Am0k-GIT/STM32F401CCU6_board/Photo/1664820074301.jpg

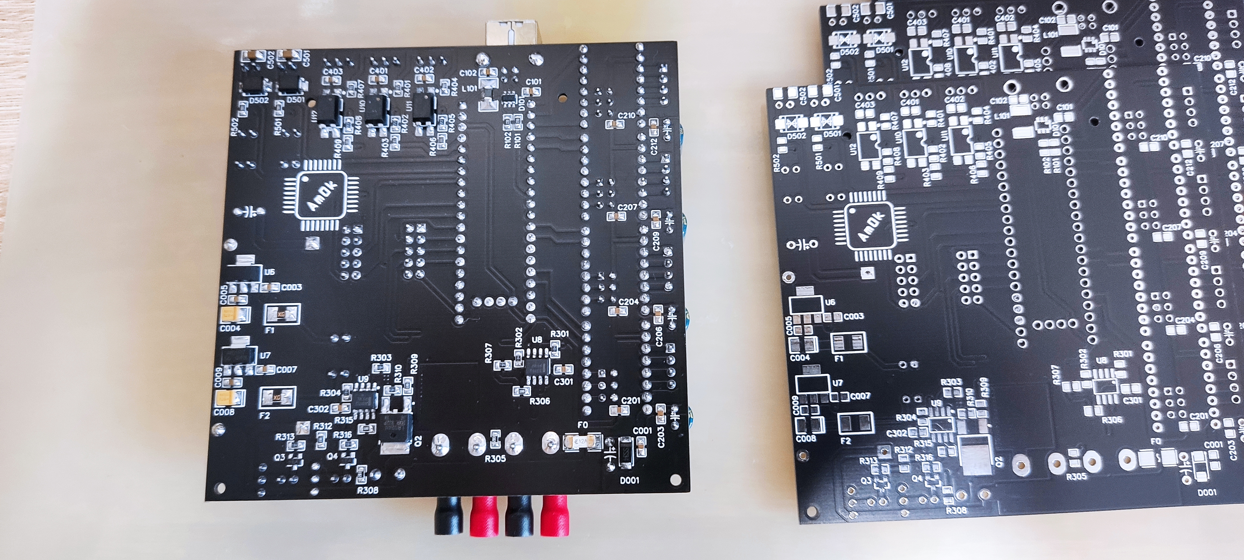
Photo/1664820074301.jpg
