Am0k-GIT/STM32F401CCU6_board/Photo/1664820074309.jpg

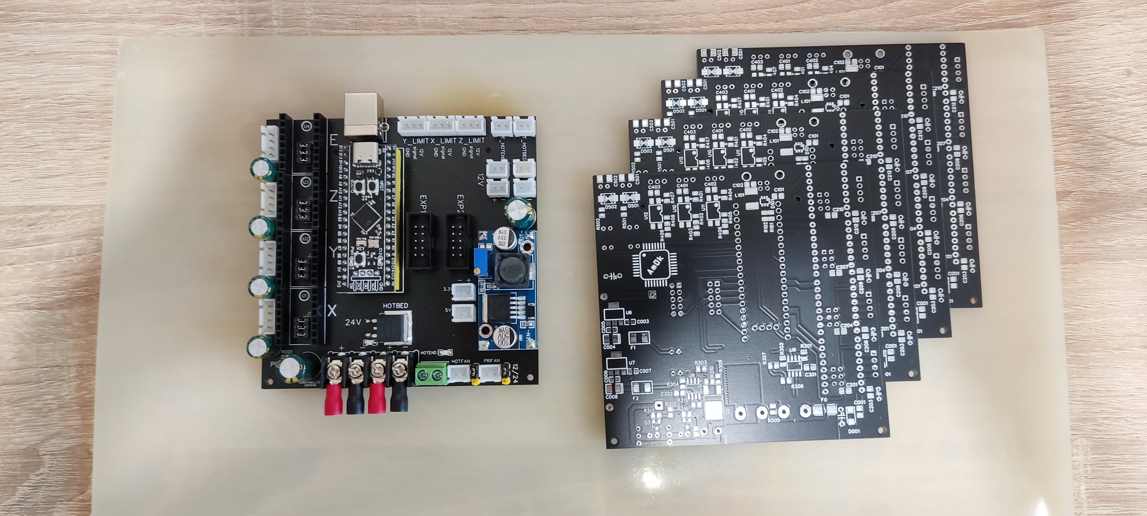
Photo/1664820074309.jpg
