Am0k-GIT/STM32F401CCU6_board/files/BOM.xlsx

Name | Designator | Quantity | Price | Total price | Link
 | Resistors
0805 SMD Resistor 10Ω | R306, R309, R312, R315 | 4 | $0.005 | $0.020 | https://aliexpress.ru/item/32858225842.html?sku_id=65342762295
0805 SMD Resistor 20Ω | R101, R102 | 2 | $0.005 | $0.010 | https://aliexpress.ru/item/32858225842.html?sku_id=65342762295
0805 SMD Resistor 100Ω | R403, R406, R409 | 3 | $0.005 | $0.015 | https://aliexpress.ru/item/32858225842.html?sku_id=65342762295
0805 SMD Resistor 1kΩ | R401, R404, R407, R501, R502 | 3 | $0.005 | $0.015 | https://aliexpress.ru/item/32858225842.html?sku_id=65342762295
0805 SMD Resistor 5.1kΩ | R001, R305, R308, R402, R405, R408 | 8 | $0.005 | $0.040 | https://aliexpress.ru/item/32858225842.html?sku_id=65342762295
0805 SMD Resistor 100kΩ | R301, R302, R303, R304, R307, R310, R313, R316 | 8 | $0.005 | $0.040 | https://aliexpress.ru/item/32858225842.html?sku_id=65342762295
 |  |  |  | $0.000
 |  |  |  | $0.000
 |  |  |  | $0.000
 | Capacitors |  |  | $0.000
0805 SMD Capacitor 0.1uF | C001, C003, C005, C007, C009, C101, C102, C201, C203, C204, C206, C207, C209, C210, C212, C301, C302, C401, C402, C403 | 20 | $0.009 | $0.180 | https://aliexpress.ru/item/32964553793.html?sku_id=66561886412
1206 SMD Capacitor 0.47uF | C501, C502 | 2 | $0.009 | $0.018 | https://aliexpress.ru/item/32966490820.html?sku_id=66631208523
Tantalum B case 68uF/10V | C004, C008 | 2 | $0.108 | $0.216 | https://aliexpress.ru/item/1005003568822210.html?sku_id=12000026320432579
Electrolytic capacitor 220uF/35V | C202, C205 ,C208, C211 | 4 | $0.049 | $0.196 | https://aliexpress.ru/item/32812576995.html?sku_id=12000021924638874
Electrolytic capacitor 470uF/25V | C002 | 1 | $0.055 | $0.055 | https://aliexpress.ru/item/32812576995.html?sku_id=12000021924638874
Electrolytic capacitor 330uF/35V | C010 | 1 | $0.094 | $0.094 | https://aliexpress.ru/item/32812576995.html?sku_id=12000021924638874
 |  |  |  | $0.000
 |  |  |  | $0.000
 |  |  |  | $0.000
 | Inductors |  |  | $0.000
1206 SMD Inductor 1uH | L101 | 1 | $0.027 | $0.027 | https://aliexpress.ru/item/32859730985.html?sku_id=65346066542
 |  |  |  | $0.000
 |  |  |  | $0.000
 |  |  |  | $0.000
 | Diodes |  |  | $0.000
SS56 | D001 | 1 | $0.029 | $0.029 | https://aliexpress.ru/item/32731083055.html?sku_id=12000025003881448
SMBJ3.3CA | D501, D502 | 2 | $0.099 | $0.198 | https://aliexpress.ru/item/1005002935595198.html?sku_id=12000022869824508
1206 LED Red | LED1, LED2, LED0 | 3 | $0.007 | $0.021 | https://aliexpress.ru/item/1206456185.html?sku_id=12000020819360623
 |  |  |  | $0.000
 |  |  |  | $0.000
 |  |  |  | $0.000
 | Mosfets |  |  | $0.000
IRLML0040TRPbF | Q3, Q4 | 2 | $0.130 | $0.260 | https://aliexpress.ru/item/33020199427.html?sku_id=67238732388
IRLR024NTRLPBF | Q2 | 1 | $0.138 | $0.138 | https://aliexpress.ru/item/32495256002.html?sku_id=56920336665
IRLS3034PBF | Q1 | 1 | $0.796 | $0.796 | https://aliexpress.ru/item/1005002717718800.html?sku_id=12000021839519371
 |  |  |  | $0.000
 |  |  |  | $0.000
 |  |  |  | $0.000
 | MC |  |  | $0.000
USBLC6-2SC6 | D101 | 1 | $0.108 | $0.108 | https://aliexpress.ru/item/32523780535.html?sku_id=12000027513378590
MC33152DR2G | U8, U9 | 2 | $0.433 | $0.866 | https://aliexpress.ru/item/32881664488.html?sku_id=12000025561707873
LM1117-3.3 | U6 | 1 | $0.368 | $0.368 | https://aliexpress.ru/item/1005003525206401.html?sku_id=12000026170984807
LM1117-5 | U7 | 1 | $0.368 | $0.368 | https://aliexpress.ru/item/1005003525206401.html?sku_id=12000026170984807
PC817S | U10, U11, U12 | 3 | $0.044 | $0.132 | https://aliexpress.ru/item/4000330808302.html?sku_id=12000015953253591
 |  |  |  | $0.000
 |  |  |  | $0.000
 |  |  |  | $0.000
 | Fuses |  |  | $0.000
1808 fuse 12A | F0 | 1 | $0.196 | $0.196 | https://aliexpress.ru/item/1005003300435636.html?sku_id=12000025095022989
1808 fuse 2A | F1 | 1 | $0.196 | $0.196 | https://aliexpress.ru/item/1005003300435636.html?sku_id=12000025095022989
3216 resetable fuse 0.5A | F2, F3 | 2 | $0.063 | $0.126 | https://aliexpress.ru/item/32876140005.html?sku_id=12000015531208019
 |  |  |  | $0.000
 |  |  |  | $0.000
 | Connectors |  |  | $0.000
XH-2.54 2pin | 3.3V, 5V, 12V_2, 12V_3, 12V_3,12V_4, HOTFAN, PRIFAN, T_HOTBED, T_HOTEND | 10 | $0.029 | $0.290 | https://aliexpress.ru/item/1005003422202370.html?sku_id=12000025716082486
XH-2.54 3pin | X_LIMIT, Y_LIMIT, Z_LIMIT | 3 | $0.031 | $0.093 | https://aliexpress.ru/item/1005003422202370.html?sku_id=12000025716082486
XH-2.54 4pin | E, X, Y, Z | 4 | $0.033 | $0.132 | https://aliexpress.ru/item/1005003422202370.html?sku_id=12000025716082486
HRD-2x3-2.54-MALE | J1, J2 ,J3, J4 | 4 | $0.058 | $0.232 | https://aliexpress.ru/item/1005004560139168.html?sku_id=12000029617433770
HRD-1x3-2.54-MALE | POWERSWITCH1, POWERSWITCH2 | 2 | $0.007 | $0.014 | https://aliexpress.ru/item/32329810741.html?sku_id=10000001992581053
KF301-5.0-2P | HOTEND | 1 | $0.034 | $0.034 | https://aliexpress.ru/item/4000290521933.html?sku_id=10000001206687839
KF7.62 4-PIN | POWER | 1 | $0.192 | $0.192 | https://aliexpress.ru/item/32924525467.html?sku_id=10000002275293516
BH-10 | EXP1, EXP2 | 2 | $0.150 | $0.300 | https://aliexpress.ru/item/1005001400147026.html?sku_id=12000015951389182
USB-B | USB1 | 1 | $0.122 | $0.122 | https://aliexpress.ru/item/32834923469.html?sku_id=64995523925
HRD-1x8-2.54-FEMALE | U1, U2, U3, U4 connectors | 8 | $0.044 | $0.352 | https://aliexpress.ru/item/32970948352.html?sku_id=66663329845
 |  |  |  | $0.000
 |  |  |  | $0.000
 |  |  |  | $0.000
 | Modules |  |  | $0.000
STM32F401CC | U0 | 1 | $2.867 | $2.867 | https://aliexpress.ru/item/32792513237.html?sku_id=10000015042616725
LM2596-Module-Schematic | U5 | 1 | $1.145 | $1.145 | https://aliexpress.ru/item/33004374185.html?sku_id=67088944738
A4988 | U1, U2, U3, U4 | 4 | $0.867 | $3.468 | https://aliexpress.ru/item/1005001621706694.html?sku_id=12000016846281613
 |  |  |  | $0.000
 |  |  |  | $0.000
 |  |  |  | $0.000
 | Manufacturing |  |  | $0.000
 | PCB build | 1 | $1.514 | $1.514 | https://jlcpcb.com/
 |  |  |  | $0.000
 |  |  |  | $0.000
 | Total: |  |  | $15.48
 | Цены приведены из учета первого попавшегося лота с заказами, включая стоимость доставки, при минимальном размере заказа, на 04.10.22
