Am0k-GIT/STM32F401CCU6_board/Schematic_Marlin_STM30F401CCU6.pdf

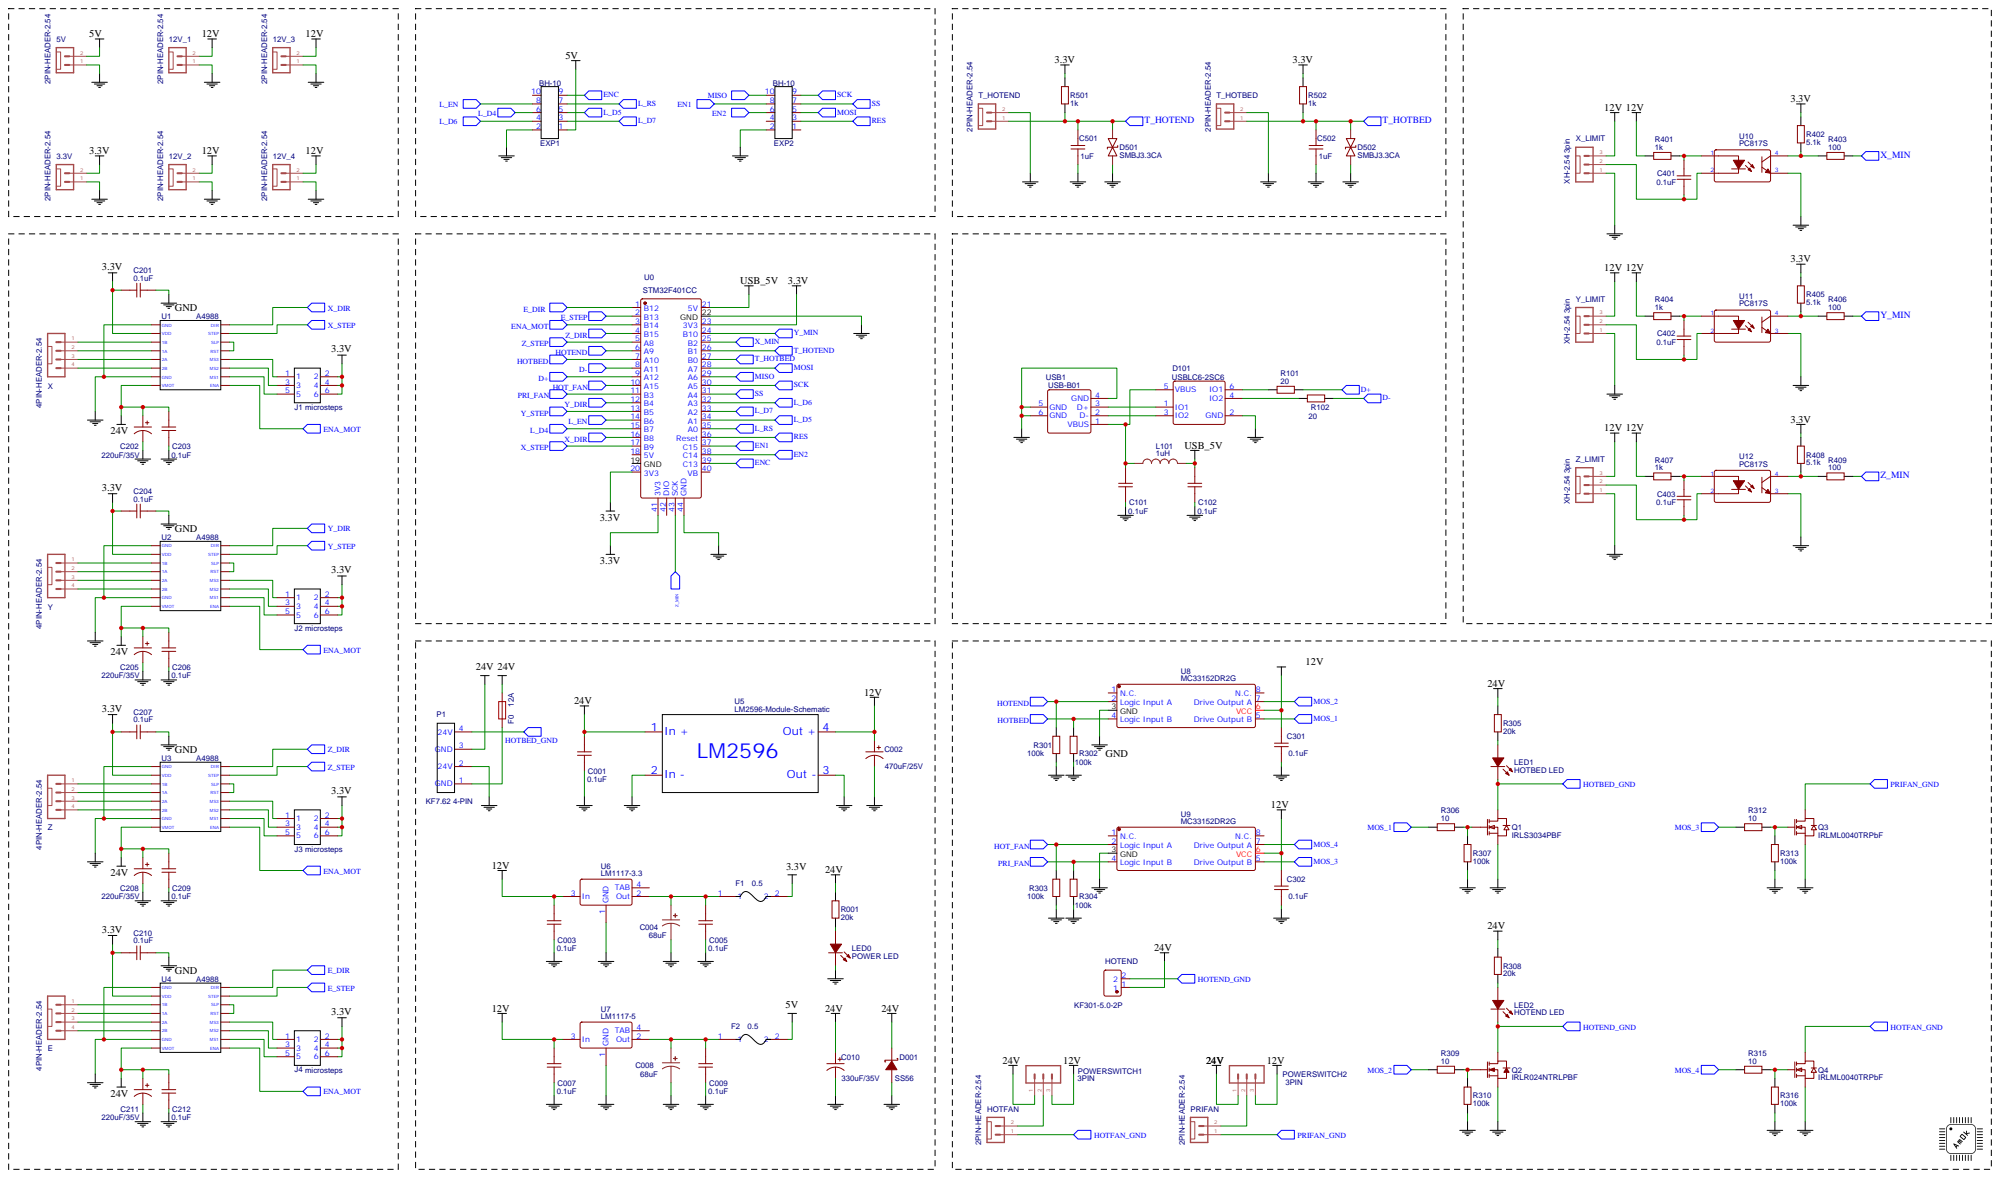
[picture p10: page 1]

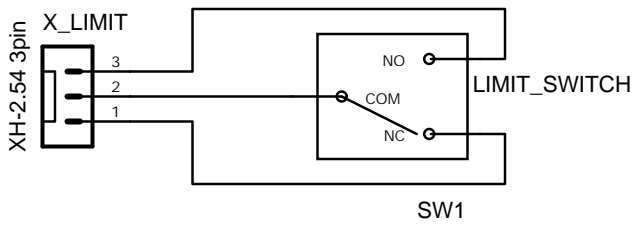
[picture p11: figure]
LIMIT_SWITCH; COM; XH-2.54 3pin; X_LIMIT
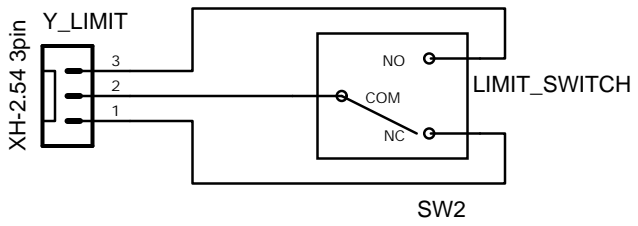
[picture p12: figure]
XH-2.54 3pin; Y_LIMIT; LIMIT_SWITCH; COM

LJ12A3-4-ZAX

SW3

Brown/VCC 1
Black/OUT 2
Blue/GND 3

### npn sensor NC

XH-2.54 3pin

Z_LIMIT

1

2

3
