Am0k-GIT/STM32F401CCU6_board/Schematic_STM32F401CCU6.pdf

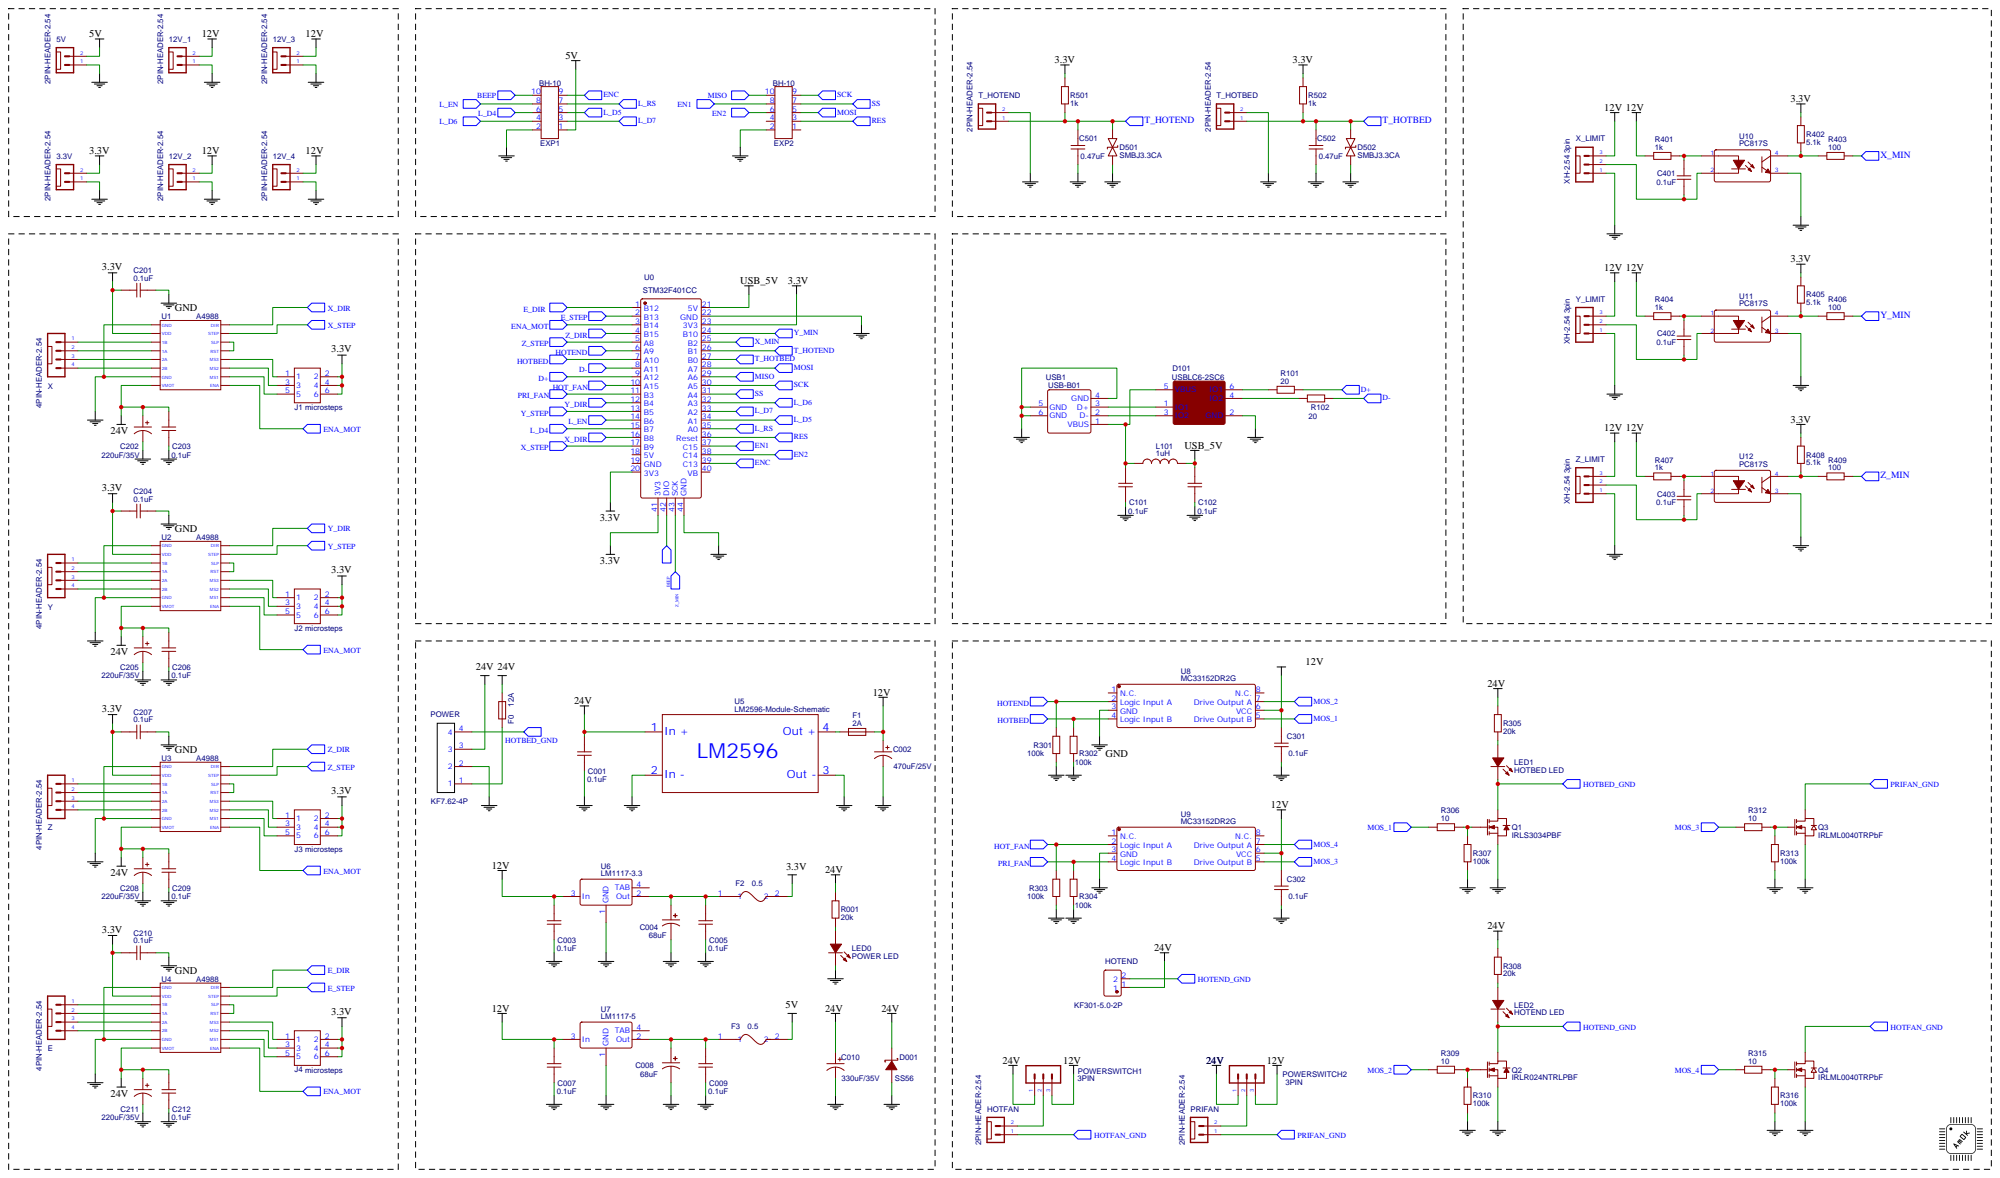
[picture p13: page 1]
