Am0k-GIT/STM32F401CCU6_board/files/Marlin-2.1.2.5/Marlin/src/pins/stm32f4/pins_STM32F401CCU6.h

/**
 * Marlin 3D Printer Firmware
 * Copyright (C) 2016 MarlinFirmware [https://github.com/MarlinFirmware/Marlin]
 *
 * Based on Sprinter and grbl.
 * Copyright (C) 2011 Camiel Gubbels / Erik van der Zalm
 *
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
 */

#if NOT_TARGET(STM32F4)
  #error "Oops! Select an STM32F4 board in 'Tools > Board.'"
#elif HOTENDS > 1 || E_STEPPERS > 1
  #error "STM32F401CCU6 boards support one hotend / E-steppers only."
#endif

#define DEFAULT_MACHINE_NAME BOARD_NAME

//
// Limit Switches
//
#ifndef X_STOP_PIN      
  #ifndef X_MIN_PIN     
    #define X_MIN_PIN      PB2
  #endif                
  #ifndef X_MAX_PIN     
    #define X_MAX_PIN      PB2
  #endif                
#endif                  
#ifndef Y_STOP_PIN      
  #ifndef Y_MIN_PIN     
    #define Y_MIN_PIN      PB10
  #endif                
  #ifndef Y_MAX_PIN     
    #define Y_MAX_PIN      PB10
  #endif                
#endif                  
#ifndef Z_STOP_PIN      
  #ifndef Z_MIN_PIN     
    #define Z_MIN_PIN      PA14
  #endif                
  #ifndef Z_MAX_PIN     
    #define Z_MAX_PIN      PA14
  #endif                
#endif                  
                        

//
// Steppers
//
// X,Y,Z,E0 enable are the same
#define X_STEP_PIN         PB9
#define X_DIR_PIN          PB8
#define X_ENABLE_PIN       PB14

#define Y_STEP_PIN         PB5
#define Y_DIR_PIN          PB4
#define Y_ENABLE_PIN       PB14

#define Z_STEP_PIN         PA8
#define Z_DIR_PIN          PB15
#define Z_ENABLE_PIN       PB14

#define E0_STEP_PIN        PB13
#define E0_DIR_PIN         PB12
#define E0_ENABLE_PIN      PB14

//
// Temperature Sensors
//
#define TEMP_0_PIN         PB1   // Analog Input (HOTEND thermistor)
#define TEMP_BED_PIN       PB0   // Analog Input (BED thermistor)

//
// Heaters / Fans
//
#define HEATER_0_PIN       PA9       // HOTEND MOSFET
#define HEATER_BED_PIN     PA10      // BED MOSFET

#define FAN0_PIN           PB3       // PRINT FAN
#define FAN1_PIN           PA15      // HOTEND FAN

#ifdef E0_AUTO_FAN_PIN
  #undef E0_AUTO_FAN_PIN
  #define E0_AUTO_FAN_PIN  FAN1_PIN
#endif

//*****************************************************************************
//********************** EEPROM settings **************************************
//*****************************************************************************

// EEPROM Emulation type, select SDCARD if you don't use BOOTLOADER or select FLASH if you use BOOTLOADER
//#define SDCARD_EEPROM_EMULATION
#define FLASH_EEPROM_EMULATION

#if ENABLED(FLASH_EEPROM_EMULATION)
  #define FLASH_EEPROM_LEVELING
  #define FLASH_SECTOR          1
  #define FLASH_UNIT_SIZE       0x4000                                         // 16k
  #define FLASH_ADDRESS_START   0x08004000                                     // board_build.offset = FLASH_ADDRESS_START - 0x08000000 +  FLASH_UNIT_SIZE
#endif

#if ENABLED(SDCARD_EEPROM_EMULATION)
  #define MARLIN_EEPROM_SIZE    0x4000                                         // 16k
#endif

//*****************************************************************************

//
/**
 *                   ______                              ______                             
 *               5V | 1  2 | GND                     NC | 1  2 | GND                        
 *    (LCD_D7) PA2  | 3  4 | PA3  (LCD_D6)        RESET | 3  4 | NC                         
 *    (LCD_D5) PA1  | 5  6   PB7  (LCD_D4)   (MOSI) PA7 | 5  6   PC14 (BTN_EN2)             
 *    (LCD_RS) PA0  | 7  8 | PB6  (LCD_EN)  (SD_SS) PA4 | 7  8 | PC15 (BTN_EN1)             
 *   (BTN_ENC) PC13 | 9  10| PA13 (BEEP)      (SCK) PA5 | 9  10| PA6  (MISO)                
 *                   ------                              ------                             
 *                    EXP1                                EXP2                              
 */

#define EXP_1_01_PIN                         -1
#define EXP_1_02_PIN                         -1
#define EXP_1_03_PIN                         PA2
#define EXP_1_04_PIN                         PA3
#define EXP_1_05_PIN                         PA1
#define EXP_1_06_PIN                         PB7
#define EXP_1_07_PIN                         PA0
#define EXP_1_08_PIN                         PB6
#define EXP_1_09_PIN                         PC13
#define EXP_1_10_PIN                         PA13

#define EXP_2_01_PIN                         -1
#define EXP_2_02_PIN                         -1
#define EXP_2_03_PIN                         -1
#define EXP_2_04_PIN                         -1
#define EXP_2_05_PIN                         PA7
#define EXP_2_06_PIN                         PC14
#define EXP_2_07_PIN                         PA4
#define EXP_2_08_PIN                         PC15
#define EXP_2_09_PIN                         PA5
#define EXP_2_10_PIN                         PA6

// SDCard
#ifdef SDSUPPORT
  #define SDSS                       EXP_2_07_PIN
  #define SD_DETECT_PIN              -1
  #define KILL_PIN                   -1
#endif

//
// LCD / Controller
//
#if HAS_WIRED_LCD
  #define BEEPER_PIN                 EXP_1_10_PIN
  #define BTN_ENC                    EXP_1_09_PIN

  #if ENABLED(CR10_STOCKDISPLAY)
//TO TEST

//    #define LCD_PINS_RS              EXP_1_07_PIN
  
//    #define BTN_EN1                  EXP_1_03_PIN
//    #define BTN_EN2                  EXP_1_05_PIN
  
//    #define LCD_PINS_EN              EXP_1_08_PIN
//    #define LCD_PINS_D4              EXP_1_06_PIN

  #elif IS_TFTGLCD_PANEL
//TO TEST

//    #undef BEEPER_PIN
//    #undef BTN_ENC

//    #if ENABLED(TFTGLCD_PANEL_SPI)
//      #define TFTGLCD_CS             EXP_2_03_PIN
//    #endif

//    #define SD_DETECT_PIN            EXP_2_07_PIN

  #else

    #define LCD_PINS_RS              EXP_1_07_PIN

    #define BTN_EN1                  EXP_2_08_PIN
    #define BTN_EN2                  EXP_2_06_PIN

    #define LCD_PINS_EN              EXP_1_08_PIN

    #if ENABLED(FYSETC_MINI_12864)

      #define DOGLCD_CS              EXP_1_08_PIN
      #define DOGLCD_A0              EXP_1_07_PIN
      #define LCD_BACKLIGHT_PIN           -1
      #define LCD_RESET_PIN          EXP_1_06_PIN  // Must be high or open for LCD to operate normally.

      #define LCD_CONTRAST_INIT      240
      #define LCD_CONTRAST_MIN       200
      #define LCD_CONTRAST_MAX       255
      
      #if EITHER(FYSETC_MINI_12864_1_2, FYSETC_MINI_12864_2_0)
        #ifndef RGB_LED_R_PIN
          #define RGB_LED_R_PIN      EXP_1_05_PIN  //not verified
        #endif
        #ifndef RGB_LED_G_PIN
          #define RGB_LED_G_PIN      EXP_1_04_PIN //not verified
        #endif
        #ifndef RGB_LED_B_PIN
          #define RGB_LED_B_PIN      EXP_1_03_PIN //not verified
        #endif
      #elif ENABLED(FYSETC_MINI_12864_2_1)
        #define NEOPIXEL_PIN         EXP_1_05_PIN
      #endif

    #else                                         // !FYSETC_MINI_12864

      #define LCD_PINS_D4            EXP_1_06_PIN

      #if IS_ULTIPANEL
        #define LCD_PINS_D5            EXP_1_05_PIN
        #define LCD_PINS_D6            EXP_1_04_PIN
        #define LCD_PINS_D7            EXP_1_03_PIN

        #if ENABLED(REPRAP_DISCOUNT_FULL_GRAPHIC_SMART_CONTROLLER)
          #define BTN_ENC_EN           LCD_PINS_D7  // Detect the presence of the encoder
        #endif
      #endif //!IS_ULTIPANEL

    #endif // !FYSETC_MINI_12864

    // Alter timing for graphical display
    #if ENABLED(U8GLIB_ST7920)
//TO TEST

//      #define BOARD_ST7920_DELAY_1           125
//      #define BOARD_ST7920_DELAY_2           125
//      #define BOARD_ST7920_DELAY_3           125
    #endif

  #endif

#endif // HAS_WIRED_LCD
