Am0k-GIT/STM32F401CCU6_board/(commit log)

2022-10-07 modified: Gerber_PCB_Marlin_STM30F401CCU6_main.zip modified: README.md new file: images/board_bottom.png new file: images/board_top.png
2022-10-07 modified: README.md
    [BOM.xlsx]
2023-02-05 update info
    [Калибровка терморезисторов.xlsx]
2023-07-26 update Marlin 2.1.2.1
    [Configuration.h, Configuration_adv.h]
