Am0k-GIT/STM32F401CCU6_board/(notices)

Notices in the files:
files/Marlin-2.1.2.5/Marlin/src/pins/stm32f4/pins_STM32F401CCU6.h:
This program is free software: you can redistribute it and/or modify
it under the terms of the GNU General Public License as published by
the Free Software Foundation, either version 3 of the License, or
(at your option) any later version.
